tchn11/diploma/README.md

# О проекте

Проект трекера призван облегчить проведение настольных ролевых игр для игроков и ведущего за счёт автоматического отслеживания параметров игровых персонажей и удобного отображения их для всех участников игры. Игрокам благодаря наглядному наличию меток на трекерах проще следить за динамически меняющимися характеристиками, состояниями и параметрами игровых персонажей, ведущему удобнее за счёт небольшого и понятного интерфейса отслеживать общее состояние играющей команды и подстраивать ситуацию за столом в случае необходимости, без дополнительных отвлечений на опрос игроков и использования метагеймовых инструментов, зачастую ломающих атмосферу в НРИ. 

Система трекинга представляет из себя комплекс из четырёх разработанных трекеров, подключённых к ПК ведущего игрока и общающихся с ним посредством разработанного протокола передачи данных. 



# Аппаратная часть проекта

Для программирования одного трекера потребуется собрать платформу следующей комплектации:
* Макетная плата (размером 100 мм на 150 мм) и больше
* 36 датчиков герконов
* STM32 NucleoF334
* Кабель micro USB
  
Питание устройства происходит за счёт питания от ПК ведущего игрока (токопотребление в среднем составляет 0.14А)

Необходимо смонтировать следующую электрическую схему




Корпус изготавливается отдельно (печать на 3D принтере)

# Структура проекта

## SW

ПО, написанное для микроконтроллера STM32 (C++14, среда STM32CubeIDE версии 1.13.2), опрашивающее матрицу из герконов и отправляющая результаты на ПК.

Диаграмма классов для удобства расширения функционала трекера представлена ниже.



Микроконтроллер общается с ПК посредством протокола передачи данных следующего вида:

Вид пакета данных, отправляемого от STM32 к ПК



Вид пакета данных, отправляемого от ПК к STM32




## UI

Программа на Python, реализующая графический интерфейс. Программа состоит из двух страниц - страницы выбора устройства и конфигурации и страницы отображения параметров




# Инструкция по запуску

ПО для STM32 необходимо загрузить на собранное устройство трекера.
Программа для ПК написана на языке Python с использованием библиотеки tkinter. После запуска будет предложено выбрать из списка COM портов соответствующий подключенному устройству и файл конфигурации. Пользовательскую конфигурацию можно добавить в соответствующий файл.
