tchn11/diploma/reports/Презентация к ВКР.pdf

# Разработка автоматизированного трекера для настольных игр

### Студент: Конаныхина Антонина Александровна, Р34102 Научный руководитель: Пинкевич Василий Юрьевич

# О трекере

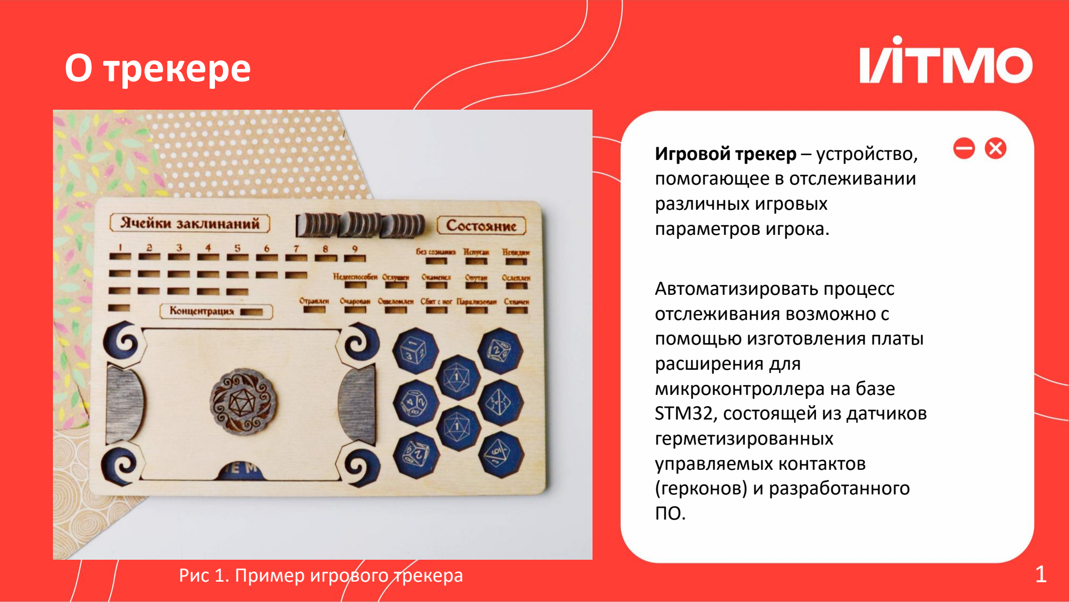
[picture p1: page 2]

Игровой трекер – устройство, помогающее в отслеживании
различных игровых
параметров игрока.

Автоматизировать процесс
отслеживания возможно с
помощью изготовления платы расширения для
микроконтроллера на базе
STM32, состоящей из датчиков герметизированных
управляемых контактов
(герконов) и разработанного ПО.
Рис 1. Пример игрового трекера | 1

- Понижение цены оборудования для НРИ
- Отсутствие аналогов
- Большой спрос на любого рода автоматизацию среди игроков
- Универсальность, возможность индивидуальной настройки конфигурации

Актуальность

# О трекере

- Повышение комфорта игроков за игровым столом
- Улучшение игрового процесса и погружения в игру без обременений
- Развитие сферы автоматизированного оборудования в комьюнити

Практическая ценность

Цель: улучшение качества игрового процесса в настольных играх за счет автоматизации
Задачи:
- Анализ существующих решений или причины их отсутствия
- Исследование работы и способов разводки принципиальных электрических схем на базе герконов
- Разработка и изготовление платы расширения для микроконтроллера STM32 Nucleo
- Написание ПО для конфигурации и настройки трекера и UI для отображения обработанных данных
- Тестирование разработанного ПО на изготовленной плате

# Цель и задачи

# Схема работы системы

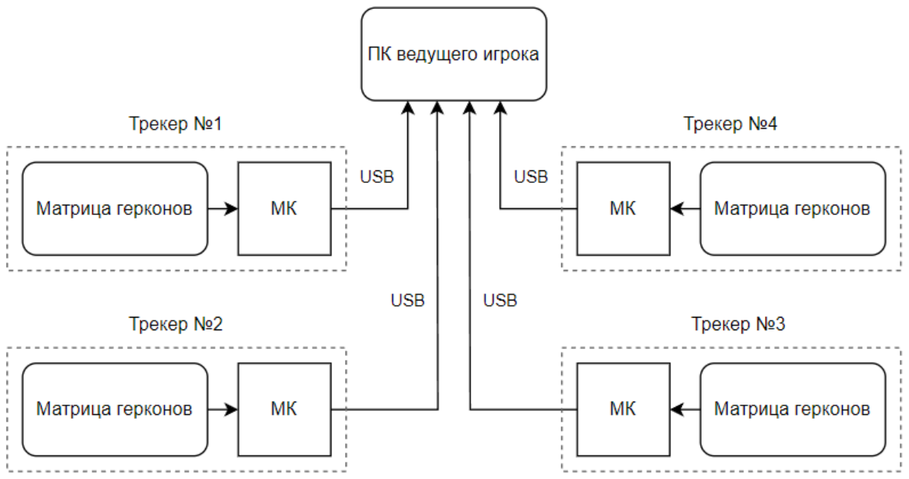
[picture p2: figure]

Рис 2. Схема работы системы с четырьмя трекерами

# Схема прямого подключения датчиков

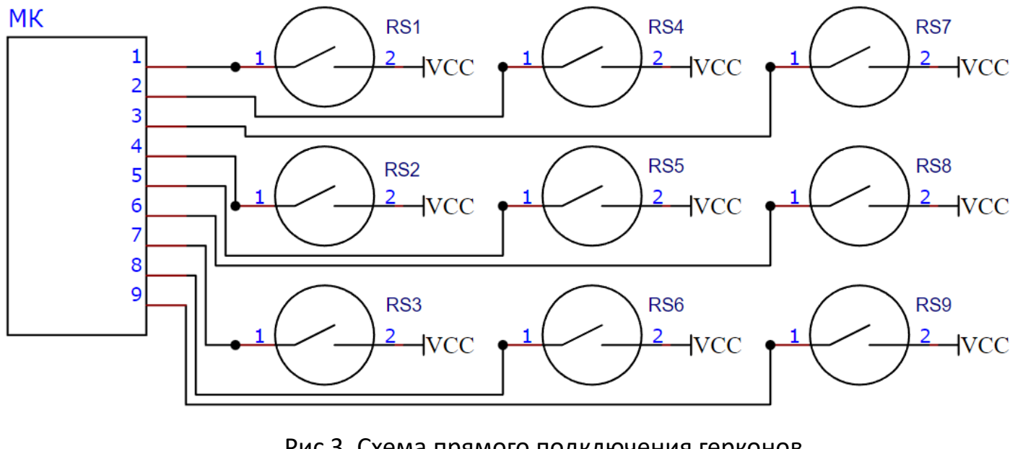
[picture p3: figure]

Рис 3. Схема прямого подключения герконов

# Схема подключения, основанная на сумме токов

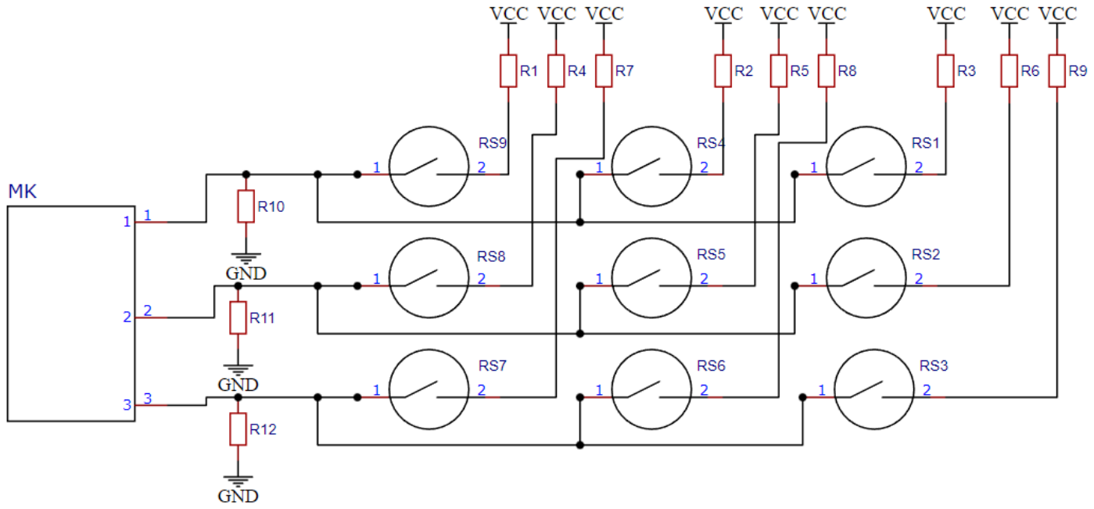
[picture p4: figure]

Рис 4. Схема подключения с суммированием токов

# Схема подключения по столбцам и строкам

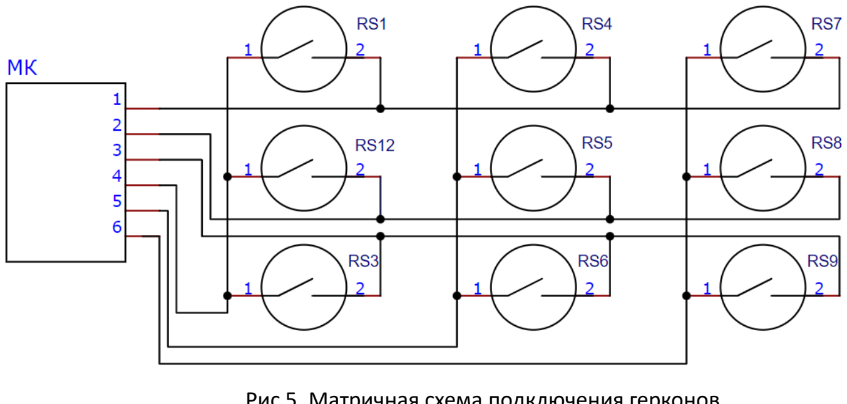
[picture p5: figure]

Рис 5. Матричная схема подключения герконов

# Принципиальная электрическая схема

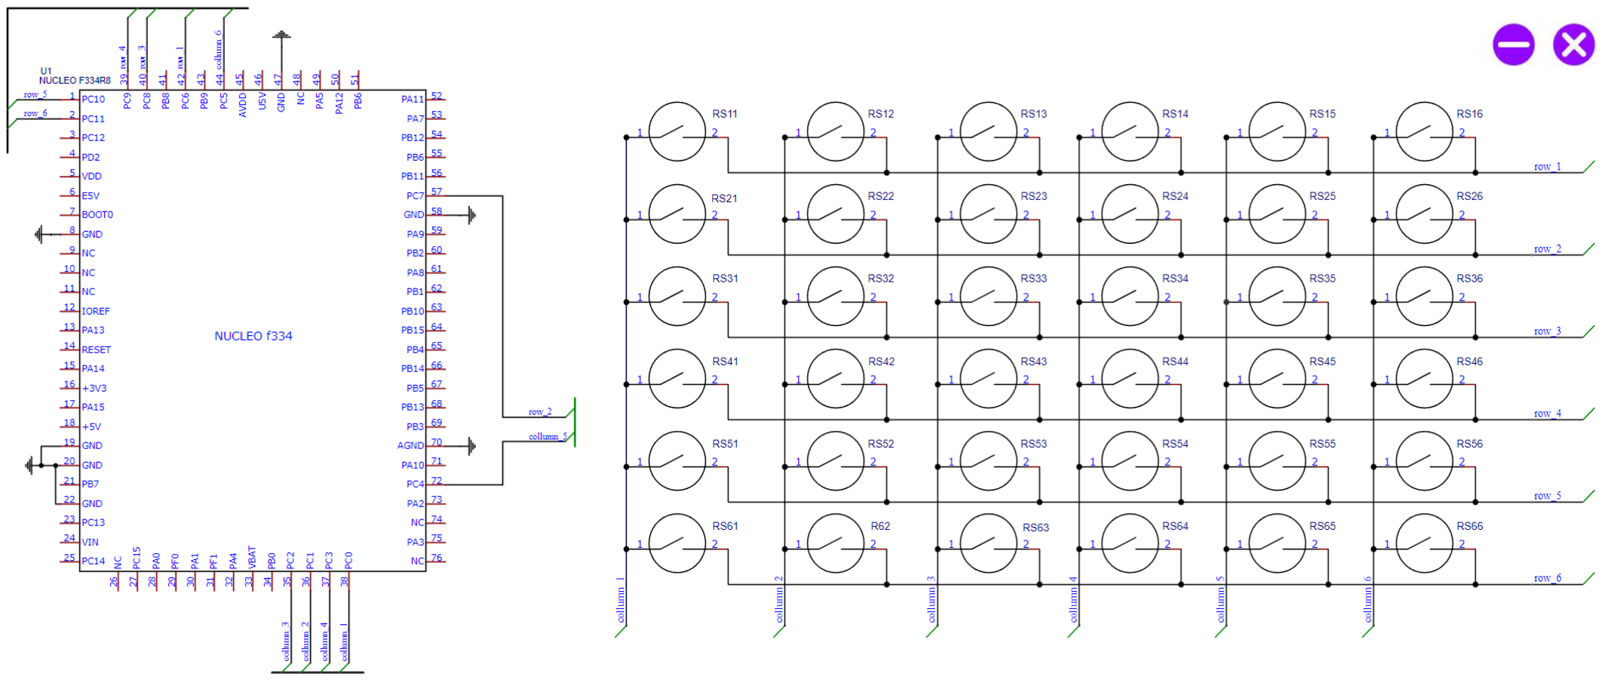
[picture p6: figure]

Рис 6. Принципиальная электрическая схема трекера

# Аппаратное обеспечение

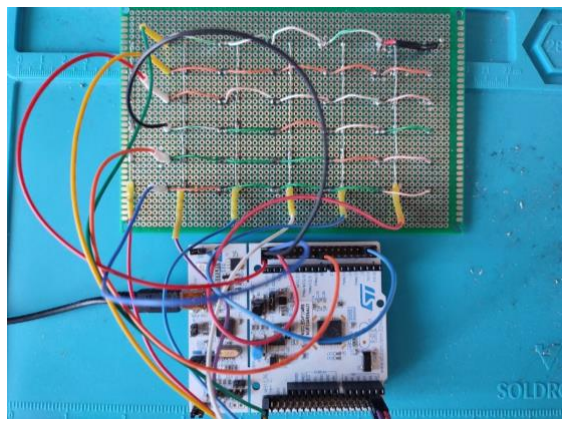
[picture p7: figure]

- Макетная плата размером 100 мм на 150 мм;
- 36 герконов;
- STM32 NucleoF334;

### - Питание устройства происходит за счёт питания от ПК ведущего игрока (токопотребление в среднем

составляет 0.14А);
- Цена прототипа: 5216 рублей.

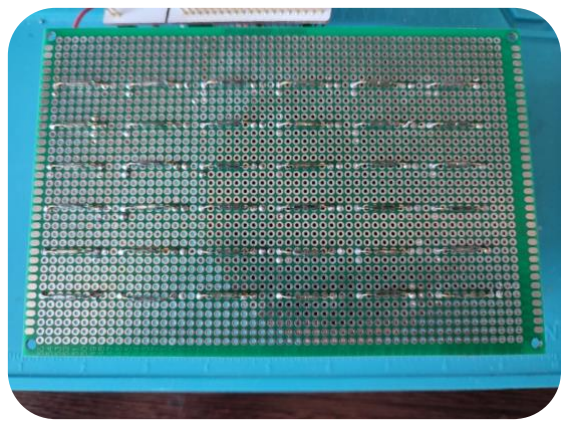
[picture p8: figure]

9 Рис 7-8. Изготовленная плата

# Программное обеспечение

## ПО состоит из двух частей: - Программа для микроконтроллера: собирает данные, обрабатывает

полученную матрицу и отправляет на ПК ведущего.

## - Программа для ПК ведущего игрока: отображает полученные с трекера

данные пользователю через графический интерфейс.

## Разработан протокол, посредством которого через интерфейс USB

коммуницируют программа для ПК и программа для микроконтроллера.

# ПО для микроконтроллера

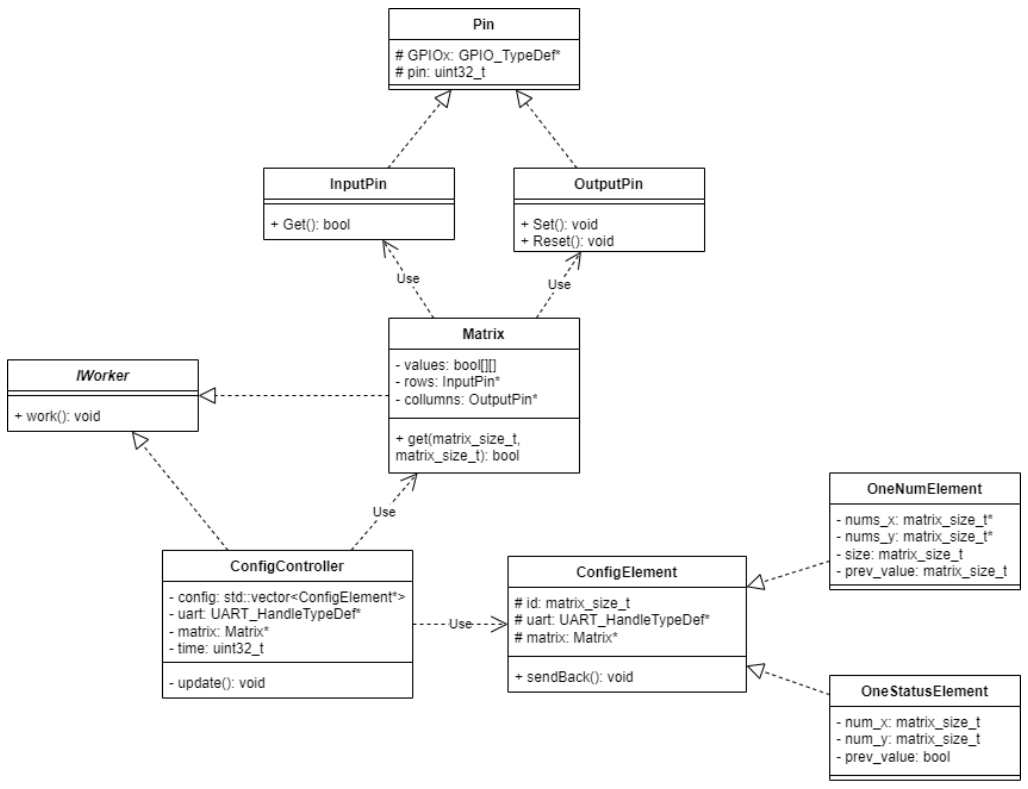
[picture p9: figure]

11 Рис 9. UML диаграмма классов ПО для МК

# Разработанный протокол общения

Вид пакета данных, отправляемого от STM32 к ПК:

Вид пакета данных, отправляемого от ПК к STM32:

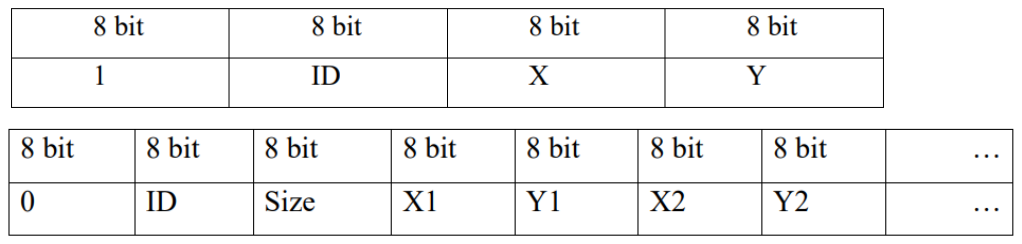
[picture p10: figure]

# UI и выводимые результаты

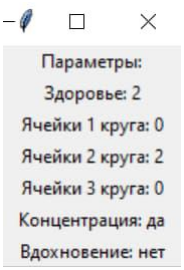
[picture p11: figure]

Рис 10. Окна пользовательской настройки | Рис 11. Считанные данные

# Спасибо за внимание!

### Конаныхина Антонина, Р34102

# Как пришла идея?

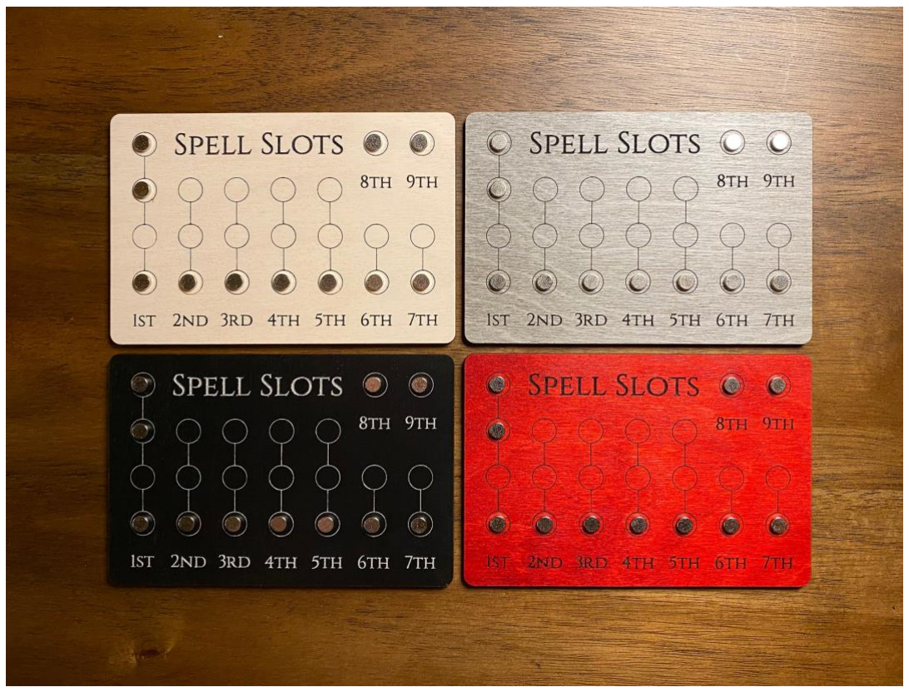
[picture p12: figure]

# Проблема фантомных нажатий

## Решения:

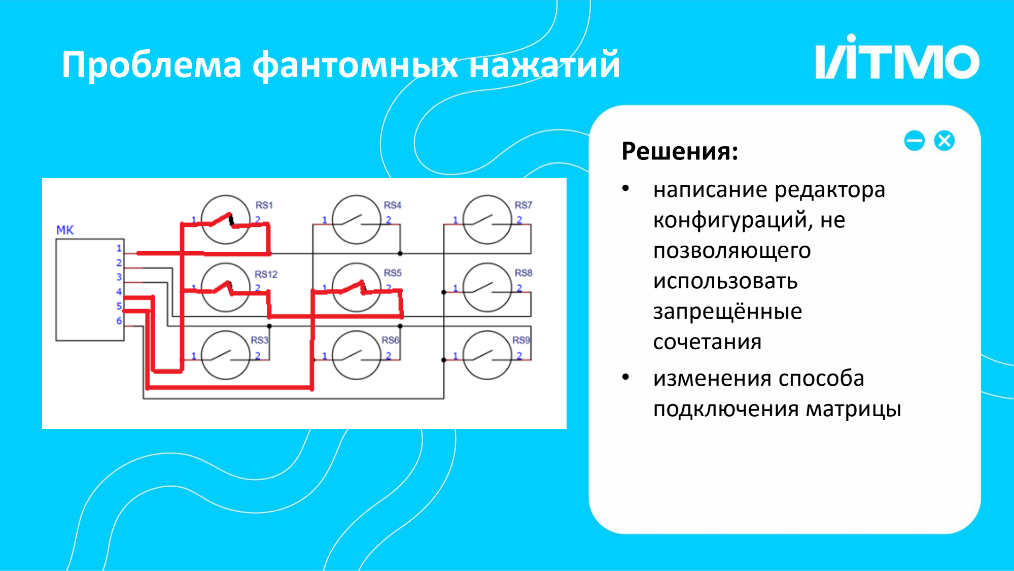
[picture p13: page 17]

### - написание редактора конфигураций, не позволяющего использовать запрещённые сочетания - изменения способа подключения матрицы

# Хранение конфигурации на ПК

### Файл конфигурации представлен текстовым файлом следующего формата:

### Данные для параметра типа «Счётчик»:

### Данные для параметра типа «Состояние»:
