tchn11/diploma/sw/Core/Src/main.cpp

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
/* Includes ------------------------------------------------------------------*/
#include "main.h"

/* USER CODE BEGIN Includes */
#include "stdint.h"
#include "matrix.h"
#include "gpio.h"
#include "config.h"
/* USER CODE END Includes */

HRTIM_HandleTypeDef hhrtim1;

UART_HandleTypeDef huart2;

void SystemClock_Config(void);
static void MX_GPIO_Init(void);
static void MX_USART2_UART_Init(void);
static void MX_HRTIM1_Init(void);
/**
  * @brief  The application entry point.
  * @retval int
  */
int main(void)
{
  /* MCU Configuration--------------------------------------------------------*/

  /* Reset of all peripherals, Initializes the Flash interface and the Systick. */
  HAL_Init();

  /* Configure the system clock */
  SystemClock_Config();

  /* Initialize all configured peripherals */
  MX_GPIO_Init();
  MX_USART2_UART_Init();
  MX_HRTIM1_Init();
  /* Infinite loop */
  /* USER CODE BEGIN WHILE */
  InputPin raw1(ROW_1_GPIO_Port, ROW_1_Pin);
  InputPin raw2(ROW_2_GPIO_Port, ROW_2_Pin);
  InputPin raw3(ROW_3_GPIO_Port, ROW_3_Pin);
  InputPin raw4(ROW_4_GPIO_Port, ROW_4_Pin);
  InputPin raw5(ROW_5_GPIO_Port, ROW_5_Pin);
  InputPin raw6(ROW_6_GPIO_Port, ROW_6_Pin);

  OutputPin collumn1(COLLUMN_1_GPIO_Port, COLLUMN_1_Pin);
  OutputPin collumn2(COLLUMN_2_GPIO_Port, COLLUMN_2_Pin);
  OutputPin collumn3(COLLUMN_3_GPIO_Port, COLLUMN_3_Pin);
  OutputPin collumn4(COLLUMN_4_GPIO_Port, COLLUMN_4_Pin);
  OutputPin collumn5(COLLUMN_5_GPIO_Port, COLLUMN_5_Pin);
  OutputPin collumn6(COLLUMN_6_GPIO_Port, COLLUMN_6_Pin);

  InputPin inputs[] = {raw1, raw2, raw3, raw4, raw5, raw6};
  OutputPin outputs[] = {collumn1, collumn2, collumn3, collumn4, collumn5, collumn6};

  Matrix matrix(inputs, outputs);

  ConfigController conf(&huart2, &matrix);
  while (1)
  {
  	matrix.work();
  	conf.work();
    /* USER CODE END WHILE */

    /* USER CODE BEGIN 3 */
  }
  /* USER CODE END 3 */
}

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
